livingcomputermuseum/MDE2/README.md

# MDE2 - MASSBUS Disk Emulator

This repository contains the Xilinx VHDL code and PCB designs for the MASSBUS Disk Emulator.

This is used in tandem with the MBS server code to emulate MASSBUS peripherals.
