livingcomputermuseum/MDE2/MDE-DR/MDE-DR-4.parts.txt

Partlist

Exported from MDE-DR-4.brd at 11/24/2014 12:50:32 PM

EAGLE Version 6.4.0 Copyright (c) 1988-2013 CadSoft

Assembly variant: 

Part     Value           Package       Library         Position (inch)       Orientation

C1       47u             C/6032-28R    rcl             (0.48 4.7)            R90
C2       47u             C/6032-28R    rcl             (8.96 4.7)            R90
C3       47u             C/6032-28R    rcl             (0.48 3.9)            R90
C4       47u             C/6032-28R    rcl             (8.96 3.9)            R90
C5       47u             C/6032-28R    rcl             (0.48 3.1)            R90
C6       47u             C/6032-28R    rcl             (8.96 3.1)            R90
C100     0.01u           C0805K        rcl             (7.6 3.25)            MR0
C101     0.01u           C0805K        rcl             (6.8 3.25)            MR0
C102     0.01u           C0805K        rcl             (5.2 3.25)            MR0
C103     0.01u           C0805K        rcl             (4.4 3.25)            MR0
C104     0.01u           C0805K        rcl             (3.6 3.25)            MR0
C105     0.01u           C0805K        rcl             (2.8 3.25)            MR0
C106     0.01u           C0805K        rcl             (2 3.25)              MR0
C107     0.01u           C0805K        rcl             (1.2 3.25)            MR0
C108     0.01u           C0805K        rcl             (8.4 3.285)           MR0
C109     0.01u           C0805K        rcl             (6 3.39)              MR0
C110     0.01u           C0805K        rcl             (8.4 4.05)            MR0
C111     0.01u           C0805K        rcl             (7.6 4.05)            MR0
C112     0.01u           C0805K        rcl             (6.8 4.05)            MR0
C113     0.01u           C0805K        rcl             (6 4.05)              MR0
C114     0.01u           C0805K        rcl             (5.2 4.05)            MR0
C115     0.01u           C0805K        rcl             (4.4 4.05)            MR0
C116     0.01u           C0805K        rcl             (3.6 4.05)            MR0
C117     0.01u           C0805K        rcl             (2.8 4.05)            MR0
C118     0.01u           C0805K        rcl             (2 4.05)              MR0
C119     0.01u           C0805K        rcl             (1.2 4.05)            MR0
C120     0.01u           C0805K        rcl             (8.38 4.85)           MR0
C121     0.01u           C0805K        rcl             (7.56 4.85)           MR0
C122     0.01u           C0805K        rcl             (6.8 4.85)            MR0
C123     0.01u           C0805K        rcl             (6 4.85)              MR0
C124     0.01u           C0805K        rcl             (5.2 4.85)            MR0
C125     0.01u           C0805K        rcl             (4.4 4.85)            MR0
C126     0.01u           C0805K        rcl             (3.6 4.85)            MR0
C127     0.01u           C0805K        rcl             (2.8 4.85)            MR0
C128     0.01u           C0805K        rcl             (2 4.85)              MR0
C129     0.01u           C0805K        rcl             (1.2 4.85)            MR0
D100     HSMS-2822       SOT23         diode           (8.63 1.8)            MR180
D101     HSMS-2822       SOT23         diode           (5.94 1.8)            MR180
D102     HSMS-2822       SOT23         diode           (3.25 1.8)            MR180
D103     1SMB5918BT3G    SMB           diode           (8.75 2.12)           MR180
J1       712RA           712RA         vulcan_custom   (9.05 2.5)            R180
LED1     APT2012SGC      SML0805       led             (8.78 2.56)           R180
LED2     APT2012EC       SML0805       led             (6.32 1.81)           R90
LED3     APT2012EC       SML0805       led             (0.94 1.8)            R90
LED4     APT2012EC       SML0805       led             (3.63 1.8)            R90
P1                       CON50L        vulcan_custom   (1.7 5.6)             R180
P2                       CON50L        vulcan_custom   (4.8 5.6)             R180
P3                       CON50L        vulcan_custom   (7.9 5.6)             R180
P4                       CON40L        vulcan_custom   (2.15 1.8)            R180
P5                       CON40L        vulcan_custom   (4.85 1.8)            R180
P6                       CON40L        vulcan_custom   (7.55 1.8)            R180
P7                       CON40L        vulcan_custom   (2.15 1.3)            R180
P8                       CON40L        vulcan_custom   (4.85 1.3)            R180
P9                       CON40L        vulcan_custom   (7.55 1.3)            R180
P10                      CON40L        vulcan_custom   (2.15 0.8)            R180
P11                      CON40L        vulcan_custom   (4.85 0.8)            R180
P12                      CON40L        vulcan_custom   (7.55 0.8)            R180
Q1       IRF7104PBF      SO-08         vulcan_custom   (6 3.16)              R270
Q2       IRF7104PBF      SO-08         vulcan_custom   (6 2.86)              R270
R1       150             R0805         rcl             (8.77 2.36)           R0
R2       150             R0805         rcl             (6.32 2)              R90
R3       150             R0805         rcl             (0.94 1.99)           R90
R4       150             R0805         rcl             (3.63 1.99)           R90
R100     4816P-T02-820LF 4816P         resistor-bourns (8.2 0.3)             MR180
R101     4816P-T02-820LF 4816P         resistor-bourns (7.2 0.3)             MR180
R102     4816P-T02-820LF 4816P         resistor-bourns (6.2 0.3)             MR180
R103     4816P-T02-820LF 4816P         resistor-bourns (5.3 0.3)             MR180
R104     4816P-T02-820LF 4816P         resistor-bourns (4.3 0.3)             MR180
R105     4816P-T02-820LF 4816P         resistor-bourns (3.4 0.3)             MR180
R106     4816P-T02-820LF 4816P         resistor-bourns (2.3 0.3)             MR180
R107     4816P-T02-820LF 4816P         resistor-bourns (1.4 0.3)             MR180
R108     10k             R0805         rcl             (5.71 3.01)           MR0
R109     1.0k            R0805         rcl             (2.8 3.1)             MR0
R110     10k             R0805         rcl             (5.71 3.14)           MR0
R111     10k             R0805         rcl             (5.71 3.24)           MR0
R112     1.0k            R0805         rcl             (3.6 3.37)            MR0
R113     1.0k            R0805         rcl             (2.8 3.37)            MR0
R114     1.0k            R0805         rcl             (8.4 3.405)           MR0
R115     1.0k            R0805         rcl             (6 3.82)              MR0
R116     1.0k            R0805         rcl             (8.4 4.17)            MR0
R117     1.0k            R0805         rcl             (3.6 4.17)            MR0
R118     1.0k            R0805         rcl             (2.81 4.18)           MR0
R119     1.0k            R0805         rcl             (3.6 4.42)            MR0
R120     1.0k            R0805         rcl             (6 4.43)              MR0
R121     1.0k            R0805         rcl             (2.81 4.43)           MR0
R122     1.0k            R0805         rcl             (2.8 4.66)            MR0
R123     1.0k            R0805         rcl             (6 4.69)              MR0
TP100    TPSTP12R        TP12R         testpad         (6.49 0.17)           MR0
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
TP188    TPSTP12R        TP12R         testpad         (2.78 5.295)          MR270
TP189    TPSTP12R        TP12R         testpad         (2.64 5.295)          MR270
TP190    TPSTP12R        TP12R         testpad         (2.5 5.295)           MR270
U1       SN751177NSR"    SO16NS        vulcan_custom   (1.2 4.7)             R270
U2       SN751177NSR"    SO16NS        vulcan_custom   (2 4.7)               R270
U3       SN751177NSR"    SO16NS        vulcan_custom   (2.8 4.7)             R270
U4       SN751177NSR"    SO16NS        vulcan_custom   (3.6 4.7)             R270
U5       SN751177NSR"    SO16NS        vulcan_custom   (4.4 4.7)             R270
U6       SN751177NSR"    SO16NS        vulcan_custom   (5.2 4.7)             R270
U7       SN751177NSR"    SO16NS        vulcan_custom   (6 4.7)               R270
U8       SN751177NSR"    SO16NS        vulcan_custom   (6.8 4.7)             R270
U9       SN751177NSR"    SO16NS        vulcan_custom   (7.56 4.7)            R270
U10      SN751177NSR"    SO16NS        vulcan_custom   (8.38 4.7)            R270
U11      SN751177NSR"    SO16NS        vulcan_custom   (1.2 3.9)             R270
U12      SN751177NSR"    SO16NS        vulcan_custom   (2 3.9)               R270
U13      SN751177NSR"    SO16NS        vulcan_custom   (2.8 3.9)             R270
U14      SN751177NSR"    SO16NS        vulcan_custom   (3.6 3.9)             R270
U15      SN751177NSR"    SO16NS        vulcan_custom   (4.4 3.9)             R270
U16      SN751177NSR"    SO16NS        vulcan_custom   (5.2 3.9)             R270
U17      SN751177NSR"    SO16NS        vulcan_custom   (6 3.9)               R270
U18      SN751177NSR"    SO16NS        vulcan_custom   (6.8 3.9)             R270
U19      SN751177NSR"    SO16NS        vulcan_custom   (7.6 3.9)             R270
U20      SN751177NSR"    SO16NS        vulcan_custom   (8.4 3.9)             R270
U21      SN74LVC1G27DBV  DBV_R-PDSO-G6 vulcan_custom   (6 3.39)              R270
U22      SN751177NSR"    SO16NS        vulcan_custom   (1.2 3.1)             R270
U23      SN751177NSR"    SO16NS        vulcan_custom   (2 3.1)               R270
U24      SN751177NSR"    SO16NS        vulcan_custom   (2.8 3.1)             R270
U25      SN751177NSR"    SO16NS        vulcan_custom   (3.6 3.1)             R270
U26      SN751177NSR"    SO16NS        vulcan_custom   (4.4 3.1)             R270
U27      SN751177NSR"    SO16NS        vulcan_custom   (5.2 3.1)             R270
U28      SN751177NSR"    SO16NS        vulcan_custom   (6.8 3.1)             R270
U29      SN751177NSR"    SO16NS        vulcan_custom   (7.6 3.1)             R270
U30      SN751177NSR"    SO16NS        vulcan_custom   (8.4 3.1)             R270
