livingcomputermuseum/MDE2/MDE-DR/MDE-DR-4.xy.xls

Part | Value | Package | Library | Position | inch | Orientation
Top Surface Components
C1 | 47u | C/6032-28R | 0.48 | 4.7 | R90
C2 | 47u | C/6032-28R | 8.96 | 4.7 | R90
C3 | 47u | C/6032-28R | 0.48 | 3.9 | R90
C4 | 47u | C/6032-28R | 8.96 | 3.9 | R90
C5 | 47u | C/6032-28R | 0.48 | 3.1 | R90
C6 | 47u | C/6032-28R | 8.96 | 3.1 | R90
LED1 | APT2012SGC | SML0805 | 8.78 | 2.56 | R180
LED2 | APT2012EC | SML0805 | 6.32 | 1.81 | R90
LED3 | APT2012EC | SML0805 | 0.94 | 1.8 | R90
LED4 | APT2012EC | SML0805 | 3.63 | 1.8 | R90
Q1 | IRF7104PBF | SO-08 | 6 | 3.16 | R270
Q2 | IRF7104PBF | SO-08 | 6 | 2.86 | R270
R1 | 150 | R0805 | 8.77 | 2.36 | R0
R2 | 150 | R0805 | 6.32 | 2 | R90
R3 | 150 | R0805 | 0.94 | 1.99 | R90
R4 | 150 | R0805 | 3.63 | 1.99 | R90
U1 | SN751177NSR | SO16NS | 1.2 | 4.7 | R270
U2 | SN751177NSR | SO16NS | 2 | 4.7 | R270
U3 | SN751177NSR | SO16NS | 2.8 | 4.7 | R270
U4 | SN751177NSR | SO16NS | 3.6 | 4.7 | R270
U5 | SN751177NSR | SO16NS | 4.4 | 4.7 | R270
U6 | SN751177NSR | SO16NS | 5.2 | 4.7 | R270
U7 | SN751177NSR | SO16NS | 6 | 4.7 | R270
U8 | SN751177NSR | SO16NS | 6.8 | 4.7 | R270
U9 | SN751177NSR | SO16NS | 7.56 | 4.7 | R270
U10 | SN751177NSR | SO16NS | 8.38 | 4.7 | R270
U11 | SN751177NSR | SO16NS | 1.2 | 3.9 | R270
U12 | SN751177NSR | SO16NS | 2 | 3.9 | R270
U13 | SN751177NSR | SO16NS | 2.8 | 3.9 | R270
U14 | SN751177NSR | SO16NS | 3.6 | 3.9 | R270
U15 | SN751177NSR | SO16NS | 4.4 | 3.9 | R270
U16 | SN751177NSR | SO16NS | 5.2 | 3.9 | R270
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
R120 | 1.0k | R0805 | 6 | 4.43 | MR0
R121 | 1.0k | R0805 | 2.81 | 4.43 | MR0
R122 | 1.0k | R0805 | 2.8 | 4.66 | MR0
R123 | 1.0k | R0805 | 6 | 4.69 | MR0
R108 | 10k | R0805 | 5.71 | 3.01 | MR0
R110 | 10k | R0805 | 5.71 | 3.14 | MR0
R111 | 10k | R0805 | 5.71 | 3.24 | MR0
