livingcomputermuseum/MDE2/MDE-DR/MDE-DR-4.brd.pdf

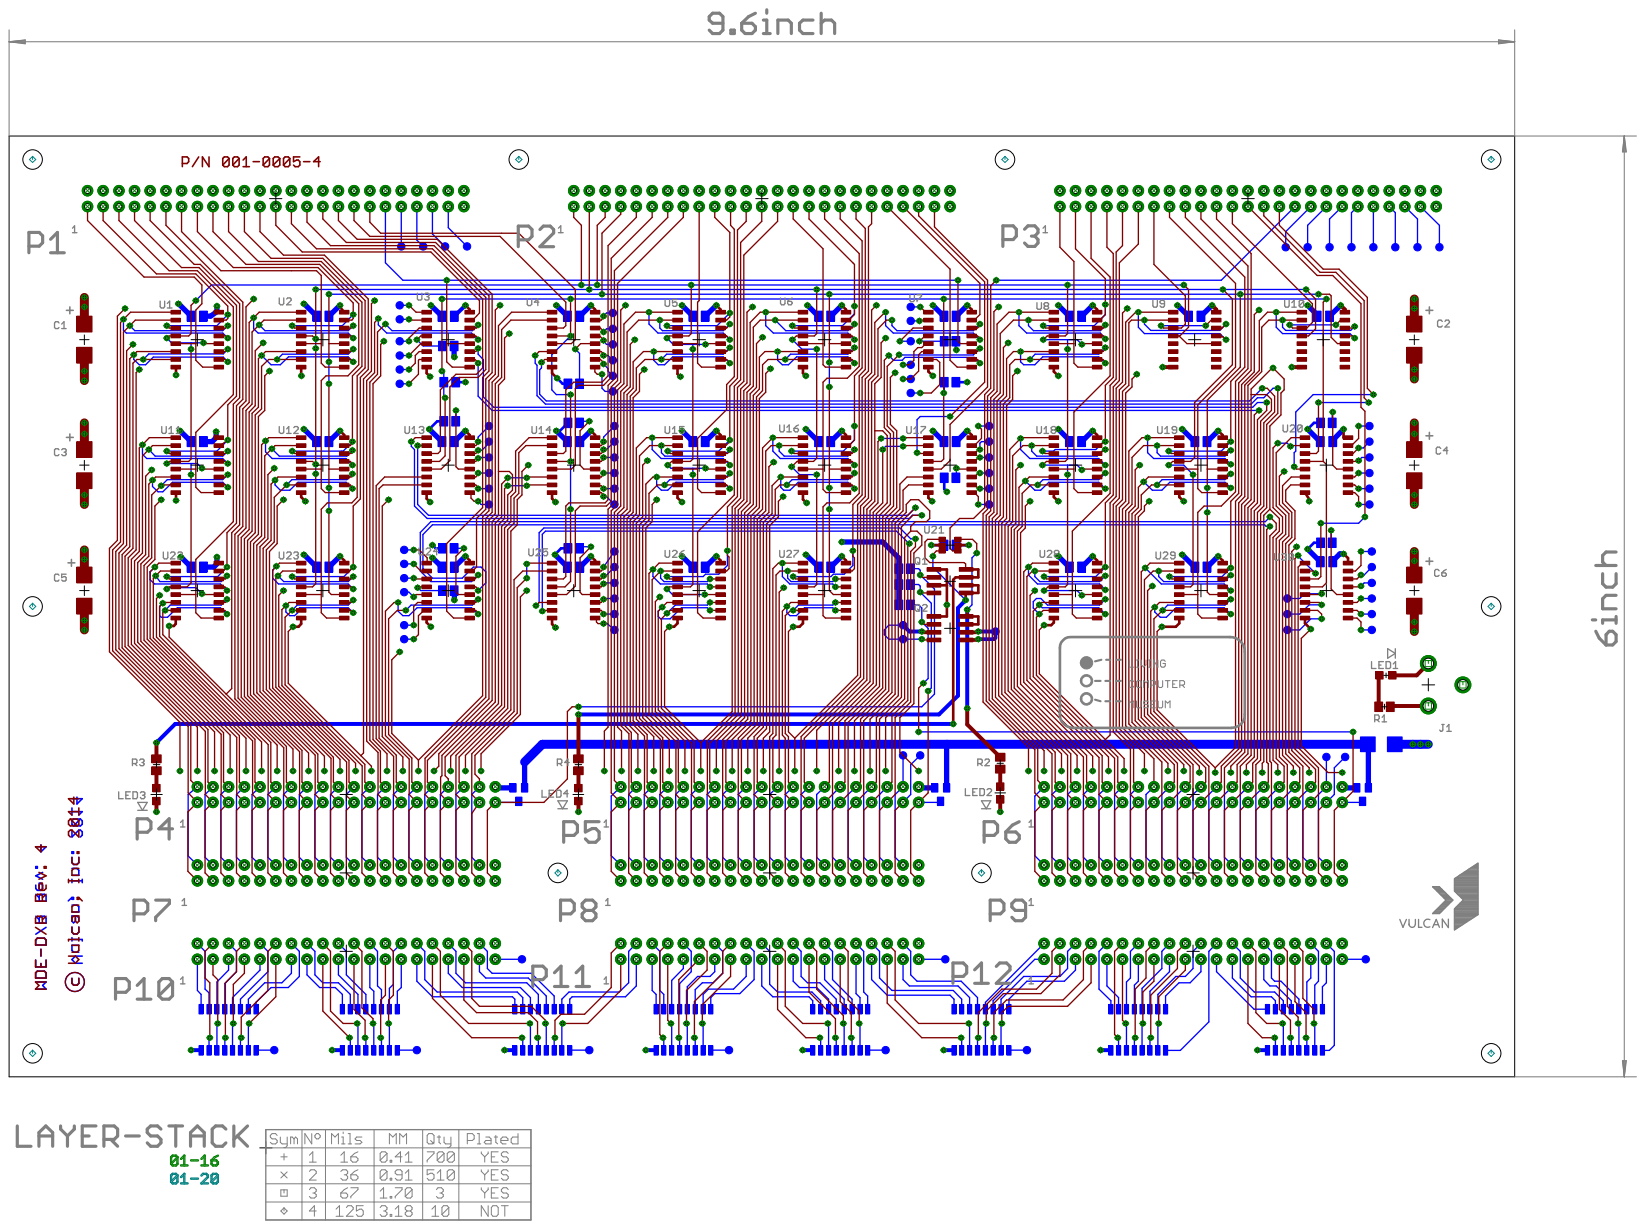
[picture p1: page 1]
