livingcomputermuseum/MDE2/MDE-DR/MDE-DR-4.brd

## EAGLE design MDE-DR/MDE-DR-4.brd (2017-12-08)

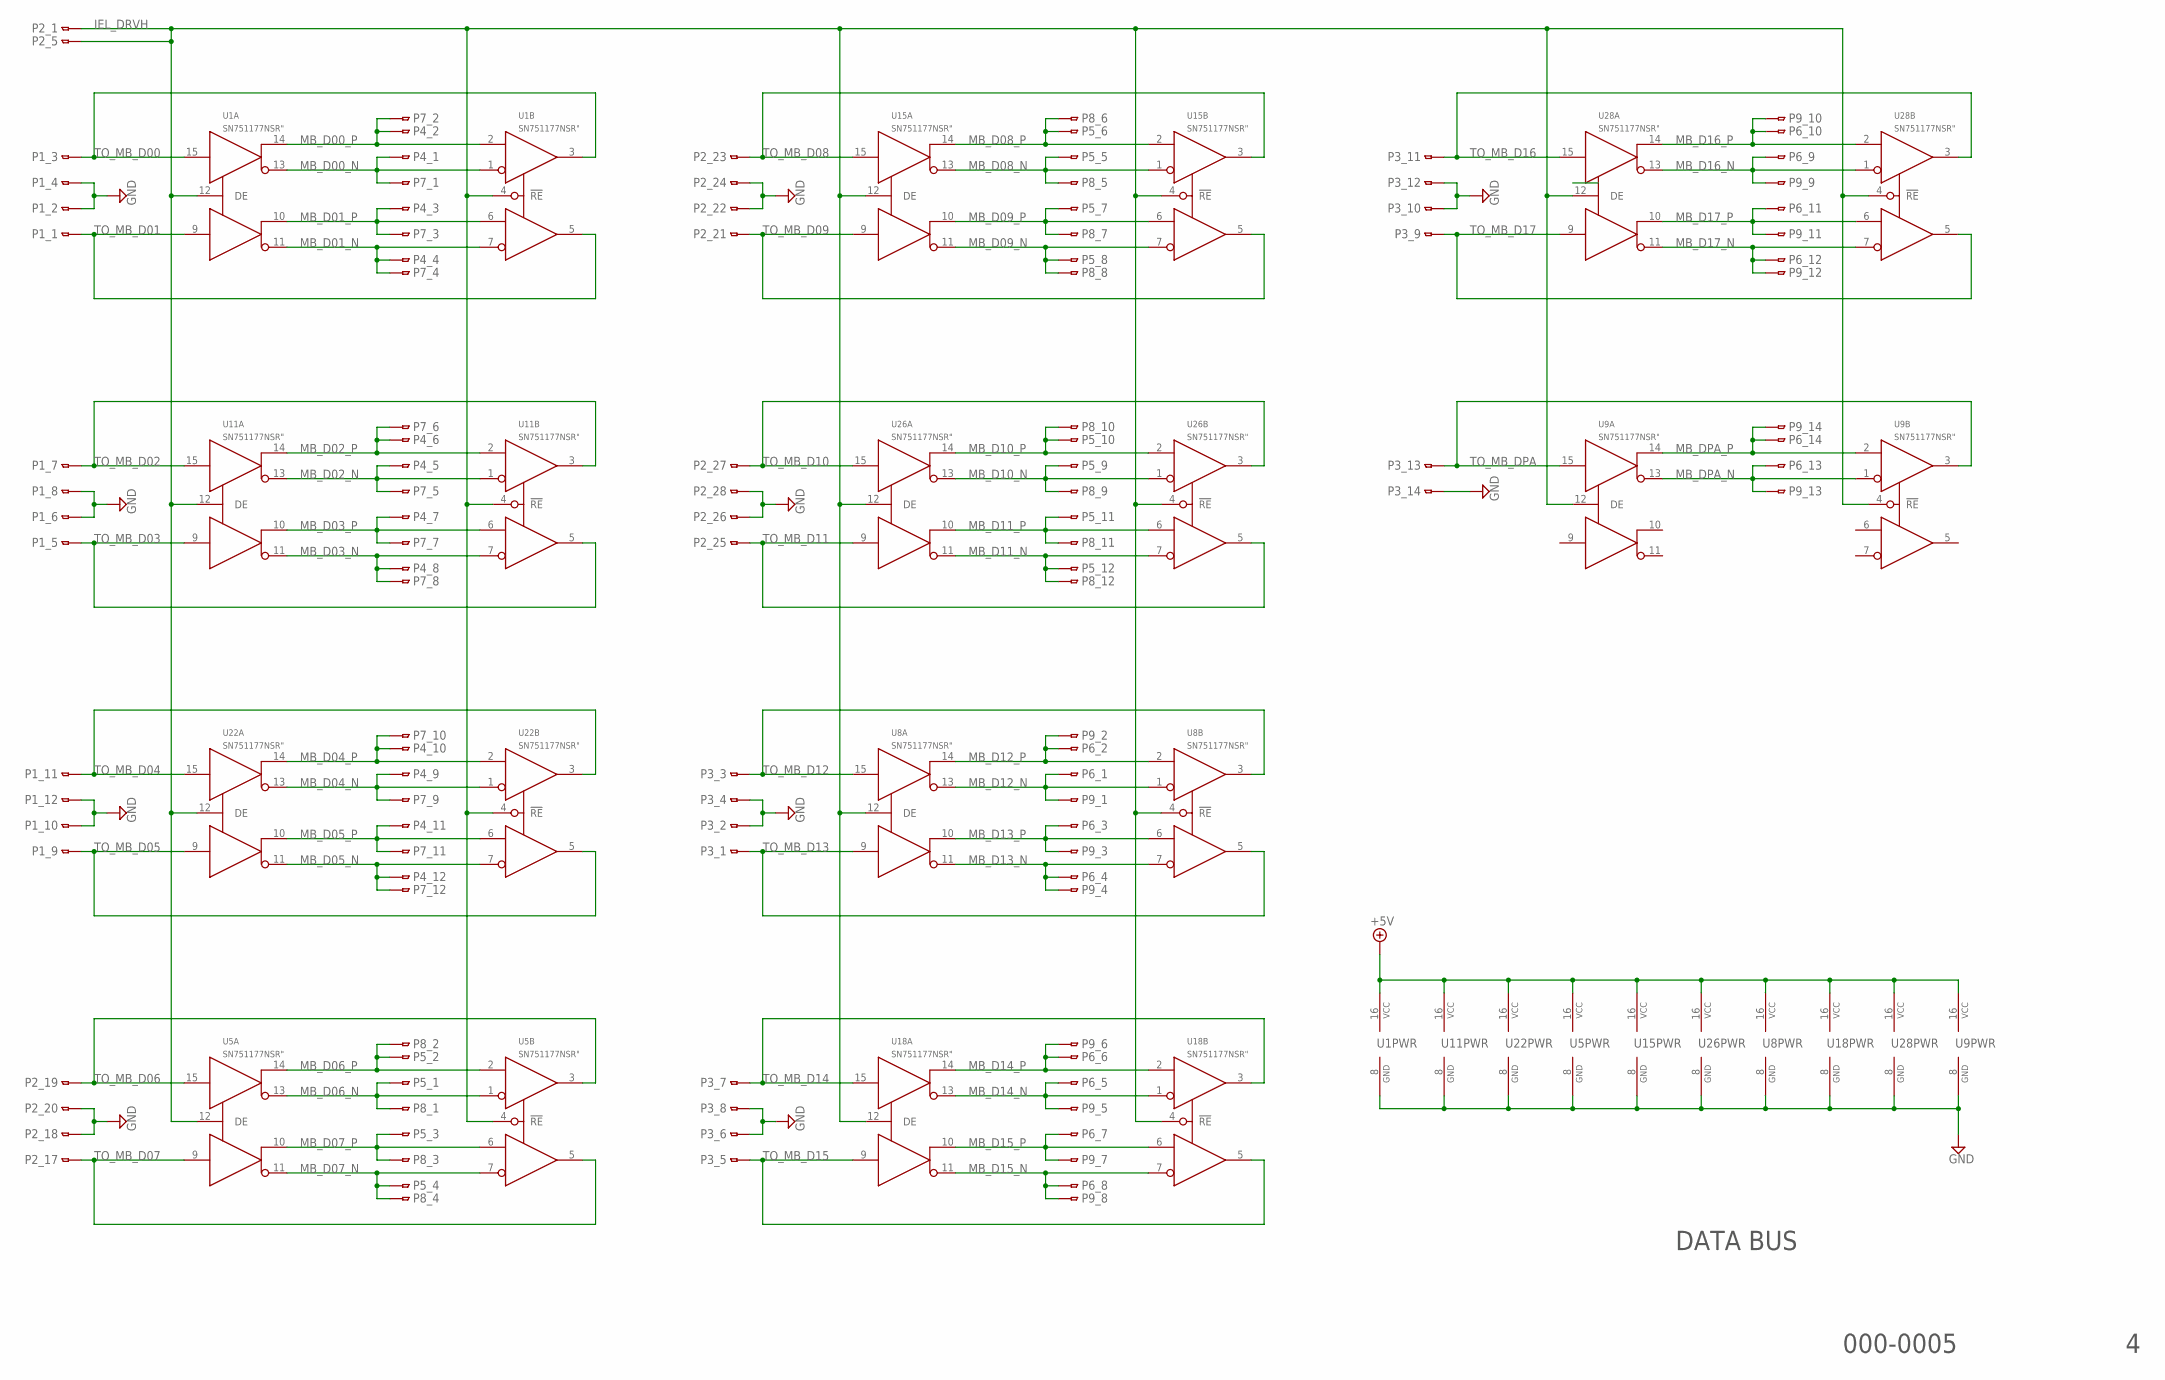
[picture p6: schematic MDE-DR-4.sch, sheet 1]

Parts:
P1, P2, P3: CON50L
P4, P5, P6, P7, P8, P9: CON40L
U1, U5, U8, U9, U11, U15, U18, U22, U26, U28: SN751177NSR"; SO16NS

Connections:
+5V: U1.16 (VCC), U5.16 (VCC), U8.16 (VCC), U9.16 (VCC), U11.16 (VCC), U15.16 (VCC), U18.16 (VCC), U22.16 (VCC), U26.16 (VCC), U28.16 (VCC); also elsewhere on the board
GND: P1.2, P1.4, P1.6, P1.8, P1.10, P1.12, P2.18, P2.20, P2.22, P2.24, P2.26, P2.28, P3.2, P3.4, P3.6, P3.8, P3.10, P3.12, P3.14, U1.8 (GND), U5.8 (GND), U8.8 (GND), U9.8 (GND), U11.8 (GND), U15.8 (GND), U18.8 (GND), U22.8 (GND), U26.8 (GND), U28.8 (GND); also elsewhere on the board
IEL_DRVH: P2.1, P2.5, U1.4 (!RE), U1.12 (DE), U5.4 (!RE), U5.12 (DE), U8.4 (!RE), U8.12 (DE), U9.4 (!RE), U9.12 (DE), U11.4 (!RE), U11.12 (DE), U15.4 (!RE), U15.12 (DE), U18.4 (!RE), U18.12 (DE), U22.4 (!RE), U22.12 (DE), U26.4 (!RE), U26.12 (DE), U28.4 (!RE), U28.12 (DE)
MB_D00_N: P4.1, P7.1, U1.1 (!1B), U1.13 (!1Z)
MB_D00_P: P4.2, P7.2, U1.2 (1A), U1.14 (1Y)
MB_D01_N: P4.4, P7.4, U1.7 (!2B), U1.11 (!2Z)
MB_D01_P: P4.3, P7.3, U1.6 (2A), U1.10 (2Y)
MB_D02_N: P4.5, P7.5, U11.1 (!1B), U11.13 (!1Z)
MB_D02_P: P4.6, P7.6, U11.2 (1A), U11.14 (1Y)
MB_D03_N: P4.8, P7.8, U11.7 (!2B), U11.11 (!2Z)
MB_D03_P: P4.7, P7.7, U11.6 (2A), U11.10 (2Y)
MB_D04_N: P4.9, P7.9, U22.1 (!1B), U22.13 (!1Z)
MB_D04_P: P4.10, P7.10, U22.2 (1A), U22.14 (1Y)
MB_D05_N: P4.12, P7.12, U22.7 (!2B), U22.11 (!2Z)
MB_D05_P: P4.11, P7.11, U22.6 (2A), U22.10 (2Y)
MB_D06_N: P5.1, P8.1, U5.1 (!1B), U5.13 (!1Z)
MB_D06_P: P5.2, P8.2, U5.2 (1A), U5.14 (1Y)
MB_D07_N: P5.4, P8.4, U5.7 (!2B), U5.11 (!2Z)
MB_D07_P: P5.3, P8.3, U5.6 (2A), U5.10 (2Y)
MB_D08_N: P5.5, P8.5, U15.1 (!1B), U15.13 (!1Z)
MB_D08_P: P5.6, P8.6, U15.2 (1A), U15.14 (1Y)
MB_D09_N: P5.8, P8.8, U15.7 (!2B), U15.11 (!2Z)
MB_D09_P: P5.7, P8.7, U15.6 (2A), U15.10 (2Y)
MB_D10_N: P5.9, P8.9, U26.1 (!1B), U26.13 (!1Z)
MB_D10_P: P5.10, P8.10, U26.2 (1A), U26.14 (1Y)
MB_D11_N: P5.12, P8.12, U26.7 (!2B), U26.11 (!2Z)
MB_D11_P: P5.11, P8.11, U26.6 (2A), U26.10 (2Y)
MB_D12_N: P6.1, P9.1, U8.1 (!1B), U8.13 (!1Z)
MB_D12_P: P6.2, P9.2, U8.2 (1A), U8.14 (1Y)
MB_D13_N: P6.4, P9.4, U8.7 (!2B), U8.11 (!2Z)
MB_D13_P: P6.3, P9.3, U8.6 (2A), U8.10 (2Y)
MB_D14_N: P6.5, P9.5, U18.1 (!1B), U18.13 (!1Z)
MB_D14_P: P6.6, P9.6, U18.2 (1A), U18.14 (1Y)
MB_D15_N: P6.8, P9.8, U18.7 (!2B), U18.11 (!2Z)
MB_D15_P: P6.7, P9.7, U18.6 (2A), U18.10 (2Y)
MB_D16_N: P6.9, P9.9, U28.1 (!1B), U28.13 (!1Z)
MB_D16_P: P6.10, P9.10, U28.2 (1A), U28.14 (1Y)
MB_D17_N: P6.12, P9.12, U28.7 (!2B), U28.11 (!2Z)
MB_D17_P: P6.11, P9.11, U28.6 (2A), U28.10 (2Y)
MB_DPA_N: P6.13, P9.13, U9.1 (!1B), U9.13 (!1Z)
MB_DPA_P: P6.14, P9.14, U9.2 (1A), U9.14 (1Y)
TO_MB_D00: P1.3, U1.3 (1R), U1.15 (1D)
TO_MB_D01: P1.1, U1.5 (2R), U1.9 (2D)
TO_MB_D02: P1.7, U11.3 (1R), U11.15 (1D)
TO_MB_D03: P1.5, U11.5 (2R), U11.9 (2D)
TO_MB_D04: P1.11, U22.3 (1R), U22.15 (1D)
TO_MB_D05: P1.9, U22.5 (2R), U22.9 (2D)
TO_MB_D06: P2.19, U5.3 (1R), U5.15 (1D)
TO_MB_D07: P2.17, U5.5 (2R), U5.9 (2D)
TO_MB_D08: P2.23, U15.3 (1R), U15.15 (1D)
TO_MB_D09: P2.21, U15.5 (2R), U15.9 (2D)
TO_MB_D10: P2.27, U26.3 (1R), U26.15 (1D)
TO_MB_D11: P2.25, U26.5 (2R), U26.9 (2D)
TO_MB_D12: P3.3, U8.3 (1R), U8.15 (1D)
TO_MB_D13: P3.1, U8.5 (2R), U8.9 (2D)
TO_MB_D14: P3.7, U18.3 (1R), U18.15 (1D)
TO_MB_D15: P3.5, U18.5 (2R), U18.9 (2D)
TO_MB_D16: P3.11, U28.3 (1R), U28.15 (1D)
TO_MB_D17: P3.9, U28.5 (2R), U28.9 (2D)
TO_MB_DPA: P3.13, U9.3 (1R), U9.15 (1D)

Notes on the sheet:
DATA BUS
000-0005

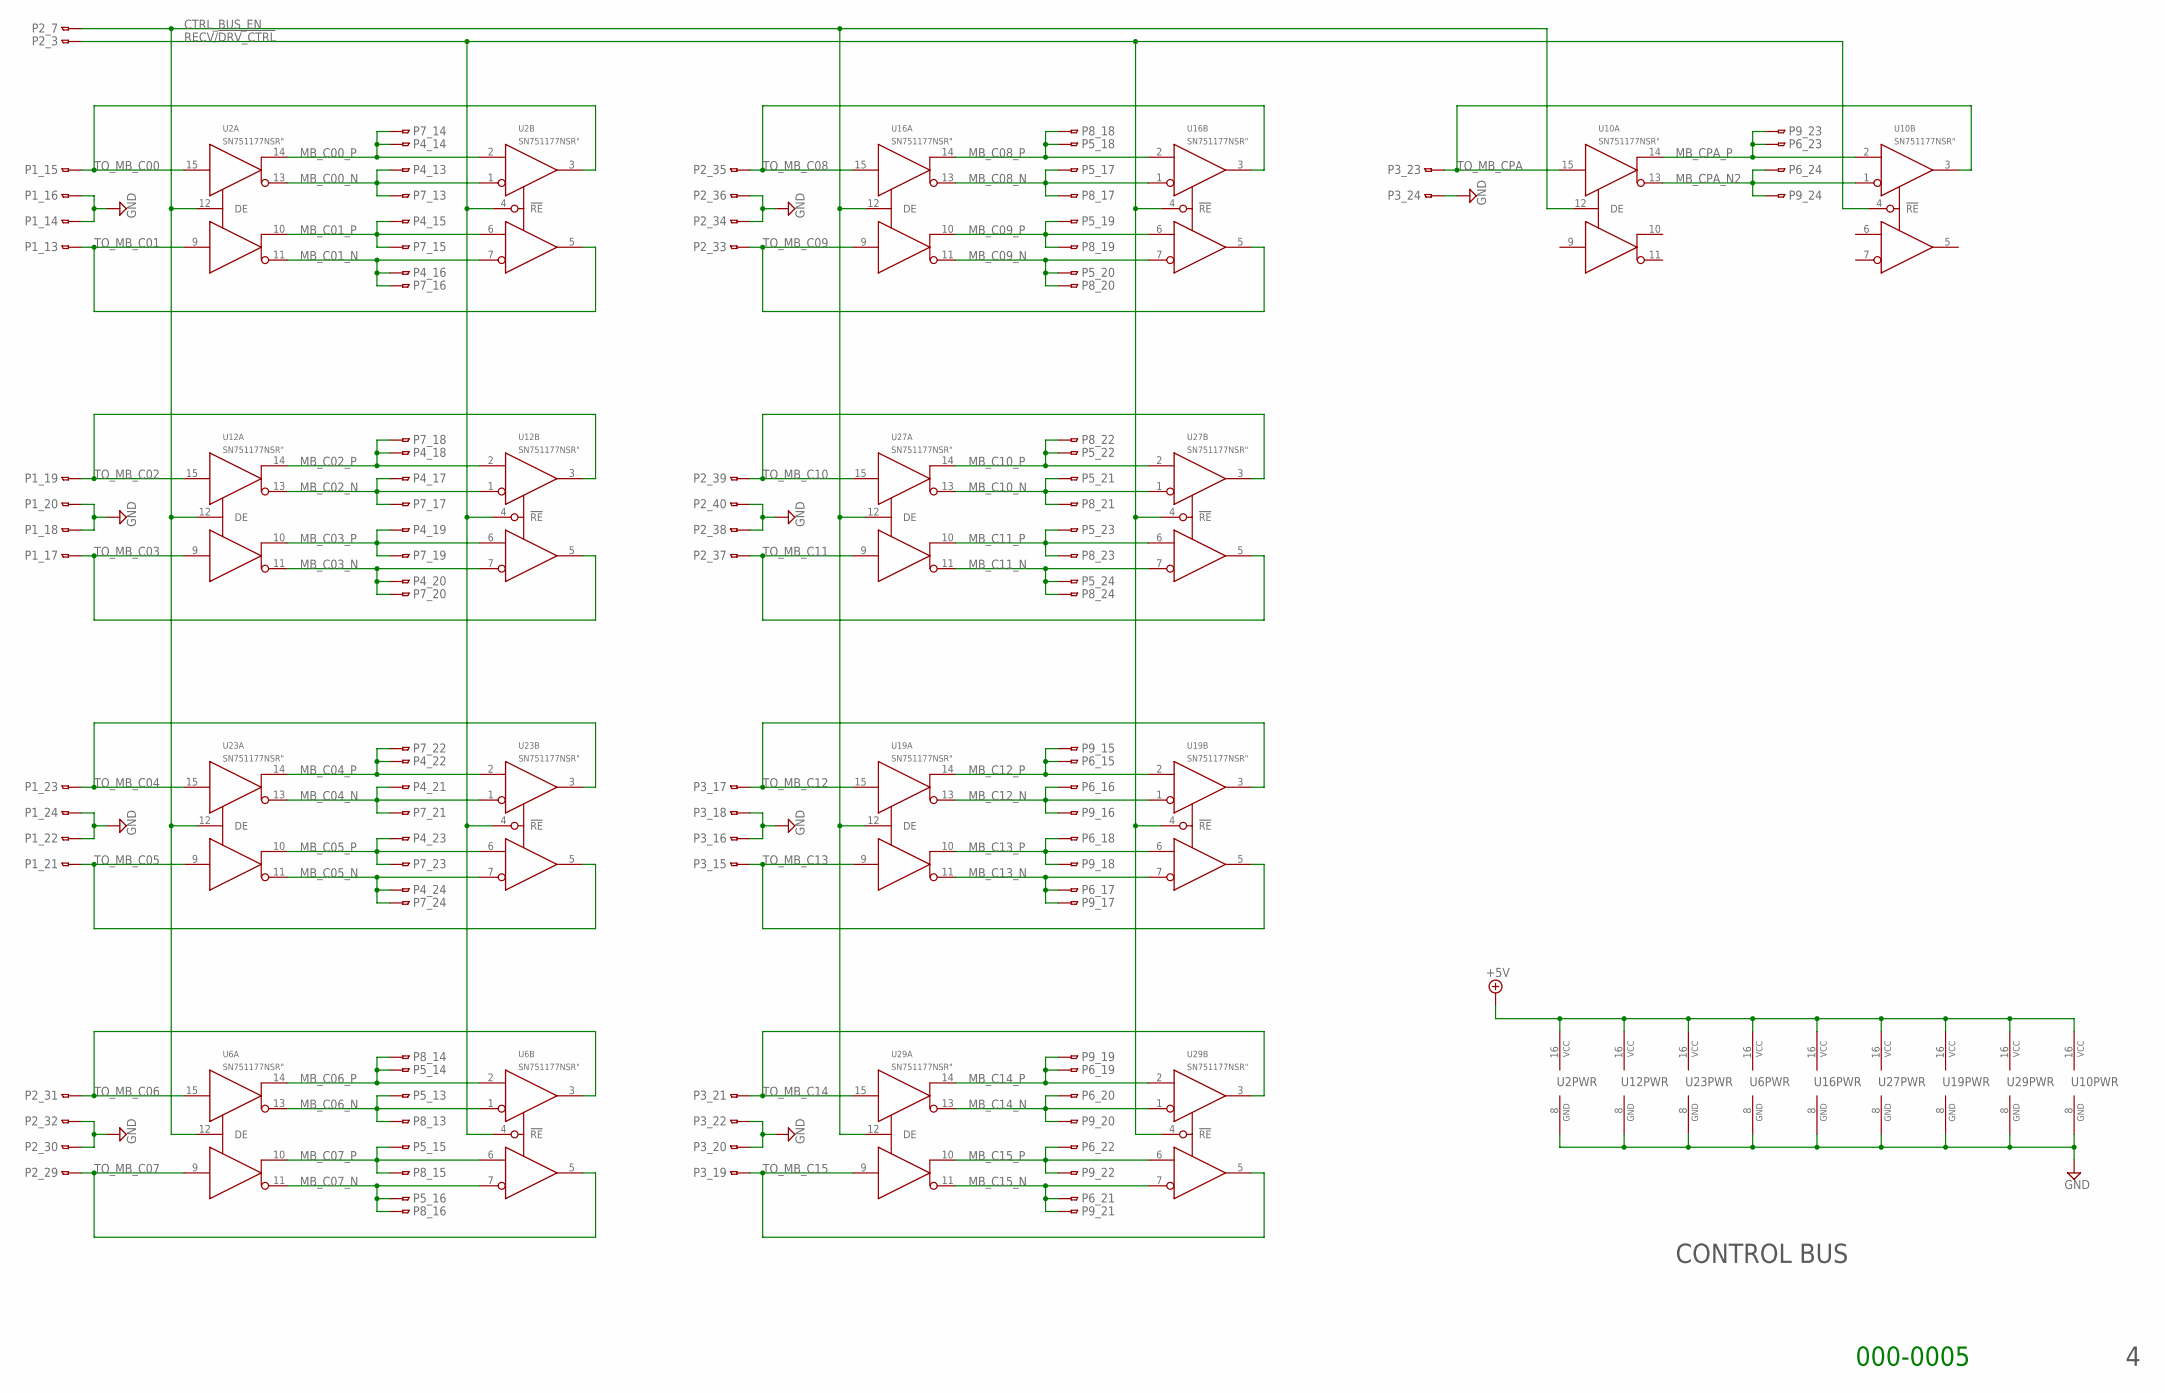
[picture p7: schematic MDE-DR-4.sch, sheet 2]

Parts:
P1, P2, P3: CON50L
P4, P5, P6, P7, P8, P9: CON40L
U2, U6, U10, U12, U16, U19, U23, U27, U29: SN751177NSR"; SO16NS

Connections:
+5V: U2.16 (VCC), U6.16 (VCC), U10.16 (VCC), U12.16 (VCC), U16.16 (VCC), U19.16 (VCC), U23.16 (VCC), U27.16 (VCC), U29.16 (VCC); also elsewhere on the board
CTRL_BUS_EN: P2.7, U2.12 (DE), U6.12 (DE), U10.12 (DE), U12.12 (DE), U16.12 (DE), U19.12 (DE), U23.12 (DE), U27.12 (DE), U29.12 (DE)
GND: P1.14, P1.16, P1.18, P1.20, P1.22, P1.24, P2.30, P2.32, P2.34, P2.36, P2.38, P2.40, P3.16, P3.18, P3.20, P3.22, P3.24, U2.8 (GND), U6.8 (GND), U10.8 (GND), U12.8 (GND), U16.8 (GND), U19.8 (GND), U23.8 (GND), U27.8 (GND), U29.8 (GND); also elsewhere on the board
MB_C00_N: P4.13, P7.13, U2.1 (!1B), U2.13 (!1Z)
MB_C00_P: P4.14, P7.14, U2.2 (1A), U2.14 (1Y)
MB_C01_N: P4.16, P7.16, U2.7 (!2B), U2.11 (!2Z)
MB_C01_P: P4.15, P7.15, U2.6 (2A), U2.10 (2Y)
MB_C02_N: P4.17, P7.17, U12.1 (!1B), U12.13 (!1Z)
MB_C02_P: P4.18, P7.18, U12.2 (1A), U12.14 (1Y)
MB_C03_N: P4.20, P7.20, U12.7 (!2B), U12.11 (!2Z)
MB_C03_P: P4.19, P7.19, U12.6 (2A), U12.10 (2Y)
MB_C04_N: P4.21, P7.21, U23.1 (!1B), U23.13 (!1Z)
MB_C04_P: P4.22, P7.22, U23.2 (1A), U23.14 (1Y)
MB_C05_N: P4.24, P7.24, U23.7 (!2B), U23.11 (!2Z)
MB_C05_P: P4.23, P7.23, U23.6 (2A), U23.10 (2Y)
MB_C06_N: P5.13, P8.13, U6.1 (!1B), U6.13 (!1Z)
MB_C06_P: P5.14, P8.14, U6.2 (1A), U6.14 (1Y)
MB_C07_N: P5.16, P8.16, U6.7 (!2B), U6.11 (!2Z)
MB_C07_P: P5.15, P8.15, U6.6 (2A), U6.10 (2Y)
MB_C08_N: P5.17, P8.17, U16.1 (!1B), U16.13 (!1Z)
MB_C08_P: P5.18, P8.18, U16.2 (1A), U16.14 (1Y)
MB_C09_N: P5.20, P8.20, U16.7 (!2B), U16.11 (!2Z)
MB_C09_P: P5.19, P8.19, U16.6 (2A), U16.10 (2Y)
MB_C10_N: P5.21, P8.21, U27.1 (!1B), U27.13 (!1Z)
MB_C10_P: P5.22, P8.22, U27.2 (1A), U27.14 (1Y)
MB_C11_N: P5.24, P8.24, U27.7 (!2B), U27.11 (!2Z)
MB_C11_P: P5.23, P8.23, U27.6 (2A), U27.10 (2Y)
MB_C12_N: P6.16, P9.16, U19.1 (!1B), U19.13 (!1Z)
MB_C12_P: P6.15, P9.15, U19.2 (1A), U19.14 (1Y)
MB_C13_N: P6.17, P9.17, U19.7 (!2B), U19.11 (!2Z)
MB_C13_P: P6.18, P9.18, U19.6 (2A), U19.10 (2Y)
MB_C14_N: P6.20, P9.20, U29.1 (!1B), U29.13 (!1Z)
MB_C14_P: P6.19, P9.19, U29.2 (1A), U29.14 (1Y)
MB_C15_N: P6.21, P9.21, U29.7 (!2B), U29.11 (!2Z)
MB_C15_P: P6.22, P9.22, U29.6 (2A), U29.10 (2Y)
MB_CPA_N2: P6.24, P9.24, U10.1 (!1B), U10.13 (!1Z)
MB_CPA_P: P6.23, P9.23, U10.2 (1A), U10.14 (1Y)
RECV/!DRV_CTRL: P2.3, U2.4 (!RE), U6.4 (!RE), U10.4 (!RE), U12.4 (!RE), U16.4 (!RE), U19.4 (!RE), U23.4 (!RE), U27.4 (!RE), U29.4 (!RE)
TO_MB_C00: P1.15, U2.3 (1R), U2.15 (1D)
TO_MB_C01: P1.13, U2.5 (2R), U2.9 (2D)
TO_MB_C02: P1.19, U12.3 (1R), U12.15 (1D)
TO_MB_C03: P1.17, U12.5 (2R), U12.9 (2D)
TO_MB_C04: P1.23, U23.3 (1R), U23.15 (1D)
TO_MB_C05: P1.21, U23.5 (2R), U23.9 (2D)
TO_MB_C06: P2.31, U6.3 (1R), U6.15 (1D)
TO_MB_C07: P2.29, U6.5 (2R), U6.9 (2D)
TO_MB_C08: P2.35, U16.3 (1R), U16.15 (1D)
TO_MB_C09: P2.33, U16.5 (2R), U16.9 (2D)
TO_MB_C10: P2.39, U27.3 (1R), U27.15 (1D)
TO_MB_C11: P2.37, U27.5 (2R), U27.9 (2D)
TO_MB_C12: P3.17, U19.3 (1R), U19.15 (1D)
TO_MB_C13: P3.15, U19.5 (2R), U19.9 (2D)
TO_MB_C14: P3.21, U29.3 (1R), U29.15 (1D)
TO_MB_C15: P3.19, U29.5 (2R), U29.9 (2D)
TO_MB_CPA: P3.23, U10.3 (1R), U10.15 (1D)

Notes on the sheet:
CONTROL BUS
000-0005

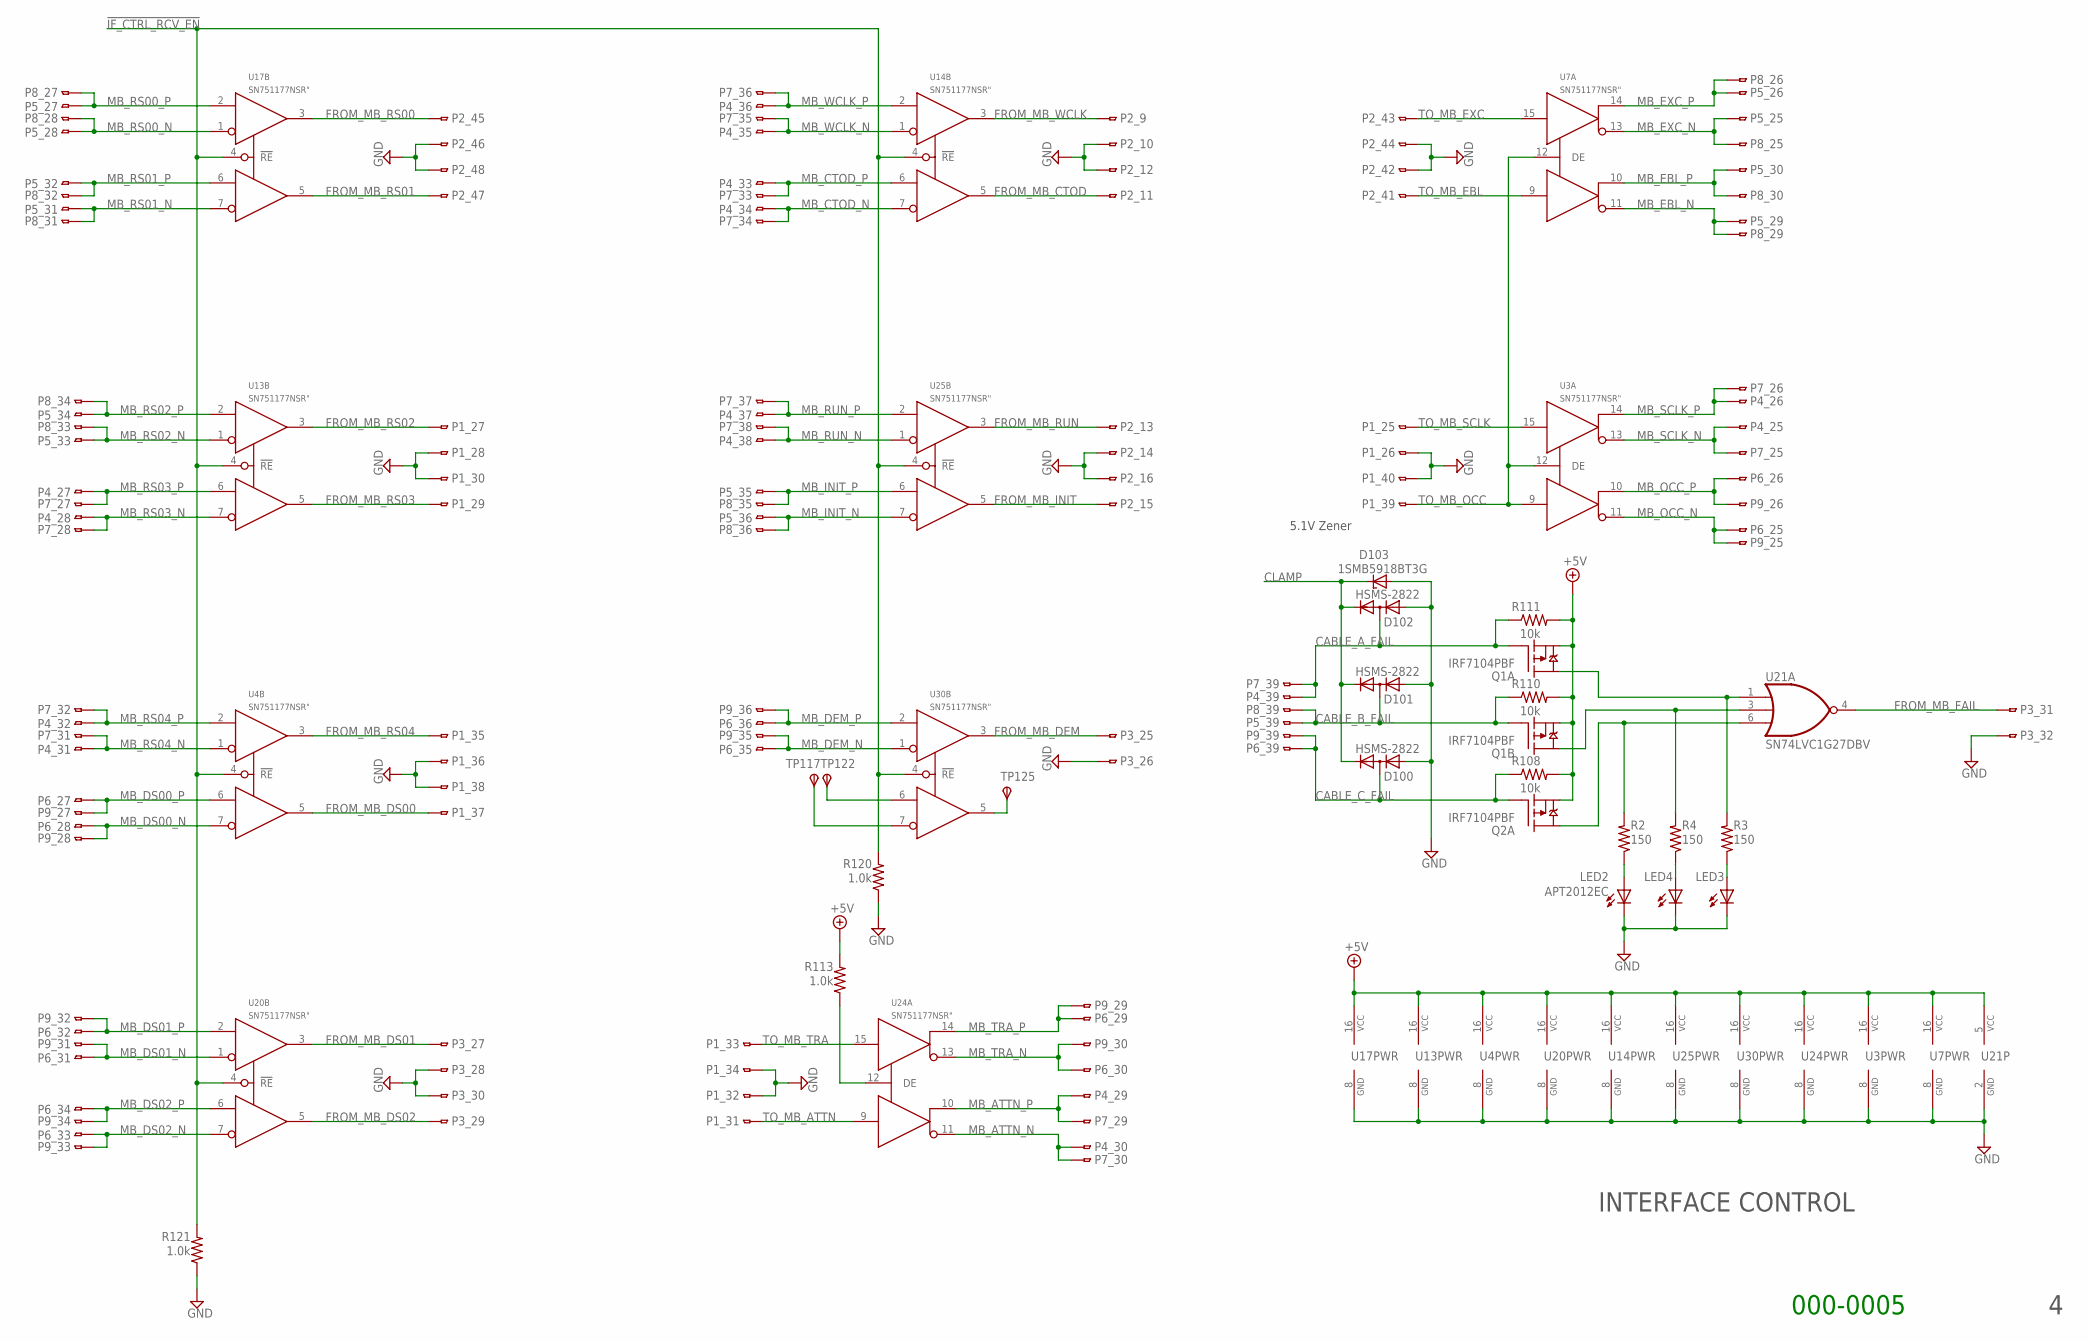
[picture p8: schematic MDE-DR-4.sch, sheet 3]

Parts:
D100, D101, D102: HSMS-2822; SOT23
D103: 1SMB5918BT3G; SMB
LED2, LED3, LED4: APT2012EC; SML0805
P1, P2, P3: CON50L
P4, P5, P6, P7, P8, P9: CON40L
Q1, Q2: IRF7104PBF; SO-08
R2, R3, R4: 150; R0805
R108, R110, R111: 10k; R0805
R113, R120, R121: 1.0k; R0805
TP117, TP122, TP125: TPSTP12R; TP12R
U3, U4, U7, U13, U14, U17, U20, U24, U25, U30: SN751177NSR"; SO16NS
U21: SN74LVC1G27DBV; DBV_R-PDSO-G6

Connections:
!IF_CTRL_RCV_EN: R120.2, R121.2, U4.4 (!RE), U13.4 (!RE), U14.4 (!RE), U17.4 (!RE), U20.4 (!RE), U25.4 (!RE), U30.4 (!RE)
+5V: Q1.1 (S), Q1.3 (S), Q2.1 (S), R108.2, R110.2, R111.2, R113.2, U3.16 (VCC), U4.16 (VCC), U7.16 (VCC), U13.16 (VCC), U14.16 (VCC), U17.16 (VCC), U20.16 (VCC), U21.5 (VCC), U24.16 (VCC), U25.16 (VCC), U30.16 (VCC); also elsewhere on the board
CABLE_A_FAIL: D102.3 (AC), P4.39, P7.39, Q1.2 (G), R111.1
CABLE_B_FAIL: D101.3 (AC), P5.39, P8.39, Q1.4 (G), R110.1
CABLE_C_FAIL: D100.3 (AC), P6.39, P9.39, Q2.2 (G), R108.1
CLAMP: D100.2 (C), D101.2 (C), D102.2 (C), D103.C
FROM_MB_CTOD: P2.11, U14.5 (2R)
FROM_MB_DEM: P3.25, U30.3 (1R)
FROM_MB_DS00: P1.37, U4.5 (2R)
FROM_MB_DS01: P3.27, U20.3 (1R)
FROM_MB_DS02: P3.29, U20.5 (2R)
FROM_MB_FAIL: P3.31, U21.4 (Y)
FROM_MB_INIT: P2.15, U25.5 (2R)
FROM_MB_RS00: P2.45, U17.3 (1R)
FROM_MB_RS01: P2.47, U17.5 (2R)
FROM_MB_RS02: P1.27, U13.3 (1R)
FROM_MB_RS03: P1.29, U13.5 (2R)
FROM_MB_RS04: P1.35, U4.3 (1R)
FROM_MB_RUN: P2.13, U25.3 (1R)
FROM_MB_WCLK: P2.9, U14.3 (1R)
GND: D100.1 (A), D101.1 (A), D102.1 (A), D103.A, LED2.C, LED3.C, LED4.C, P1.26, P1.28, P1.30, P1.32, P1.34, P1.36, P1.38, P1.40, P2.10, P2.12, P2.14, P2.16, P2.42, P2.44, P2.46, P2.48, P3.26, P3.28, P3.30, P3.32, R120.1, R121.1, U3.8 (GND), U4.8 (GND), U7.8 (GND), U13.8 (GND), U14.8 (GND), U17.8 (GND), U20.8 (GND), U21.2 (GND), U24.8 (GND), U25.8 (GND), U30.8 (GND); also elsewhere on the board
MB_ATTN_N: P4.30, P7.30, U24.11 (!2Z)
MB_ATTN_P: P4.29, P7.29, U24.10 (2Y)
MB_CTOD_N: P4.34, P7.34, U14.7 (!2B)
MB_CTOD_P: P4.33, P7.33, U14.6 (2A)
MB_DEM_N: P6.35, P9.35, U30.1 (!1B)
MB_DEM_P: P6.36, P9.36, U30.2 (1A)
MB_DS00_N: P6.28, P9.28, U4.7 (!2B)
MB_DS00_P: P6.27, P9.27, U4.6 (2A)
MB_DS01_N: P6.31, P9.31, U20.1 (!1B)
MB_DS01_P: P6.32, P9.32, U20.2 (1A)
MB_DS02_N: P6.33, P9.33, U20.7 (!2B)
MB_DS02_P: P6.34, P9.34, U20.6 (2A)
MB_EBL_N: P5.29, P8.29, U7.11 (!2Z)
MB_EBL_P: P5.30, P8.30, U7.10 (2Y)
MB_EXC_N: P5.25, P8.25, U7.13 (!1Z)
MB_EXC_P: P5.26, P8.26, U7.14 (1Y)
MB_INIT_N: P5.36, P8.36, U25.7 (!2B)
MB_INIT_P: P5.35, P8.35, U25.6 (2A)
MB_OCC_N: P6.25, P9.25, U3.11 (!2Z)
MB_OCC_P: P6.26, P9.26, U3.10 (2Y)
MB_RS00_N: P5.28, P8.28, U17.1 (!1B)
MB_RS00_P: P5.27, P8.27, U17.2 (1A)
MB_RS01_N: P5.31, P8.31, U17.7 (!2B)
MB_RS01_P: P5.32, P8.32, U17.6 (2A)
MB_RS02_N: P5.33, P8.33, U13.1 (!1B)
MB_RS02_P: P5.34, P8.34, U13.2 (1A)
MB_RS03_N: P4.28, P7.28, U13.7 (!2B)
MB_RS03_P: P4.27, P7.27, U13.6 (2A)
MB_RS04_N: P4.31, P7.31, U4.1 (!1B)
MB_RS04_P: P4.32, P7.32, U4.2 (1A)
MB_RUN_N: P4.38, P7.38, U25.1 (!1B)
MB_RUN_P: P4.37, P7.37, U25.2 (1A)
MB_SCLK_N: P4.25, P7.25, U3.13 (!1Z)
MB_SCLK_P: P4.26, P7.26, U3.14 (1Y)
MB_TRA_N: P6.30, P9.30, U24.13 (!1Z)
MB_TRA_P: P6.29, P9.29, U24.14 (1Y)
MB_WCLK_N: P4.35, P7.35, U14.1 (!1B)
MB_WCLK_P: P4.36, P7.36, U14.2 (1A)
unnamed: R113.1, U24.12 (DE)
unnamed: TP117.TP, U30.7 (!2B)
unnamed: LED2.A, R2.1
unnamed: Q2.7 (D), Q2.8 (D), R2.2, U21.6 (C)
unnamed: Q1.5 (D), Q1.6 (D), R4.2, U21.3 (B)
unnamed: Q1.7 (D), Q1.8 (D), R3.2, U21.1 (A)
unnamed: LED4.A, R4.1
unnamed: LED3.A, R3.1
unnamed: TP125.TP, U30.5 (2R)
unnamed: TP122.TP, U30.6 (2A)
TO_MB_ATTN: P1.31, U24.9 (2D)
TO_MB_EBL: P2.41, U7.9 (2D)
TO_MB_EXC: P2.43, U7.15 (1D)
TO_MB_OCC: P1.39, U3.9 (2D), U3.12 (DE), U7.12 (DE)
TO_MB_SCLK: P1.25, U3.15 (1D)
TO_MB_TRA: P1.33, U24.15 (1D)

Notes on the sheet:
INTERFACE CONTROL
5.1V Zener
000-0005
