livingcomputermuseum/MDE2/MDE-DR/MDE-DR-4.brd

## EAGLE design MDE-DR/MDE-DR-4.brd (continued)

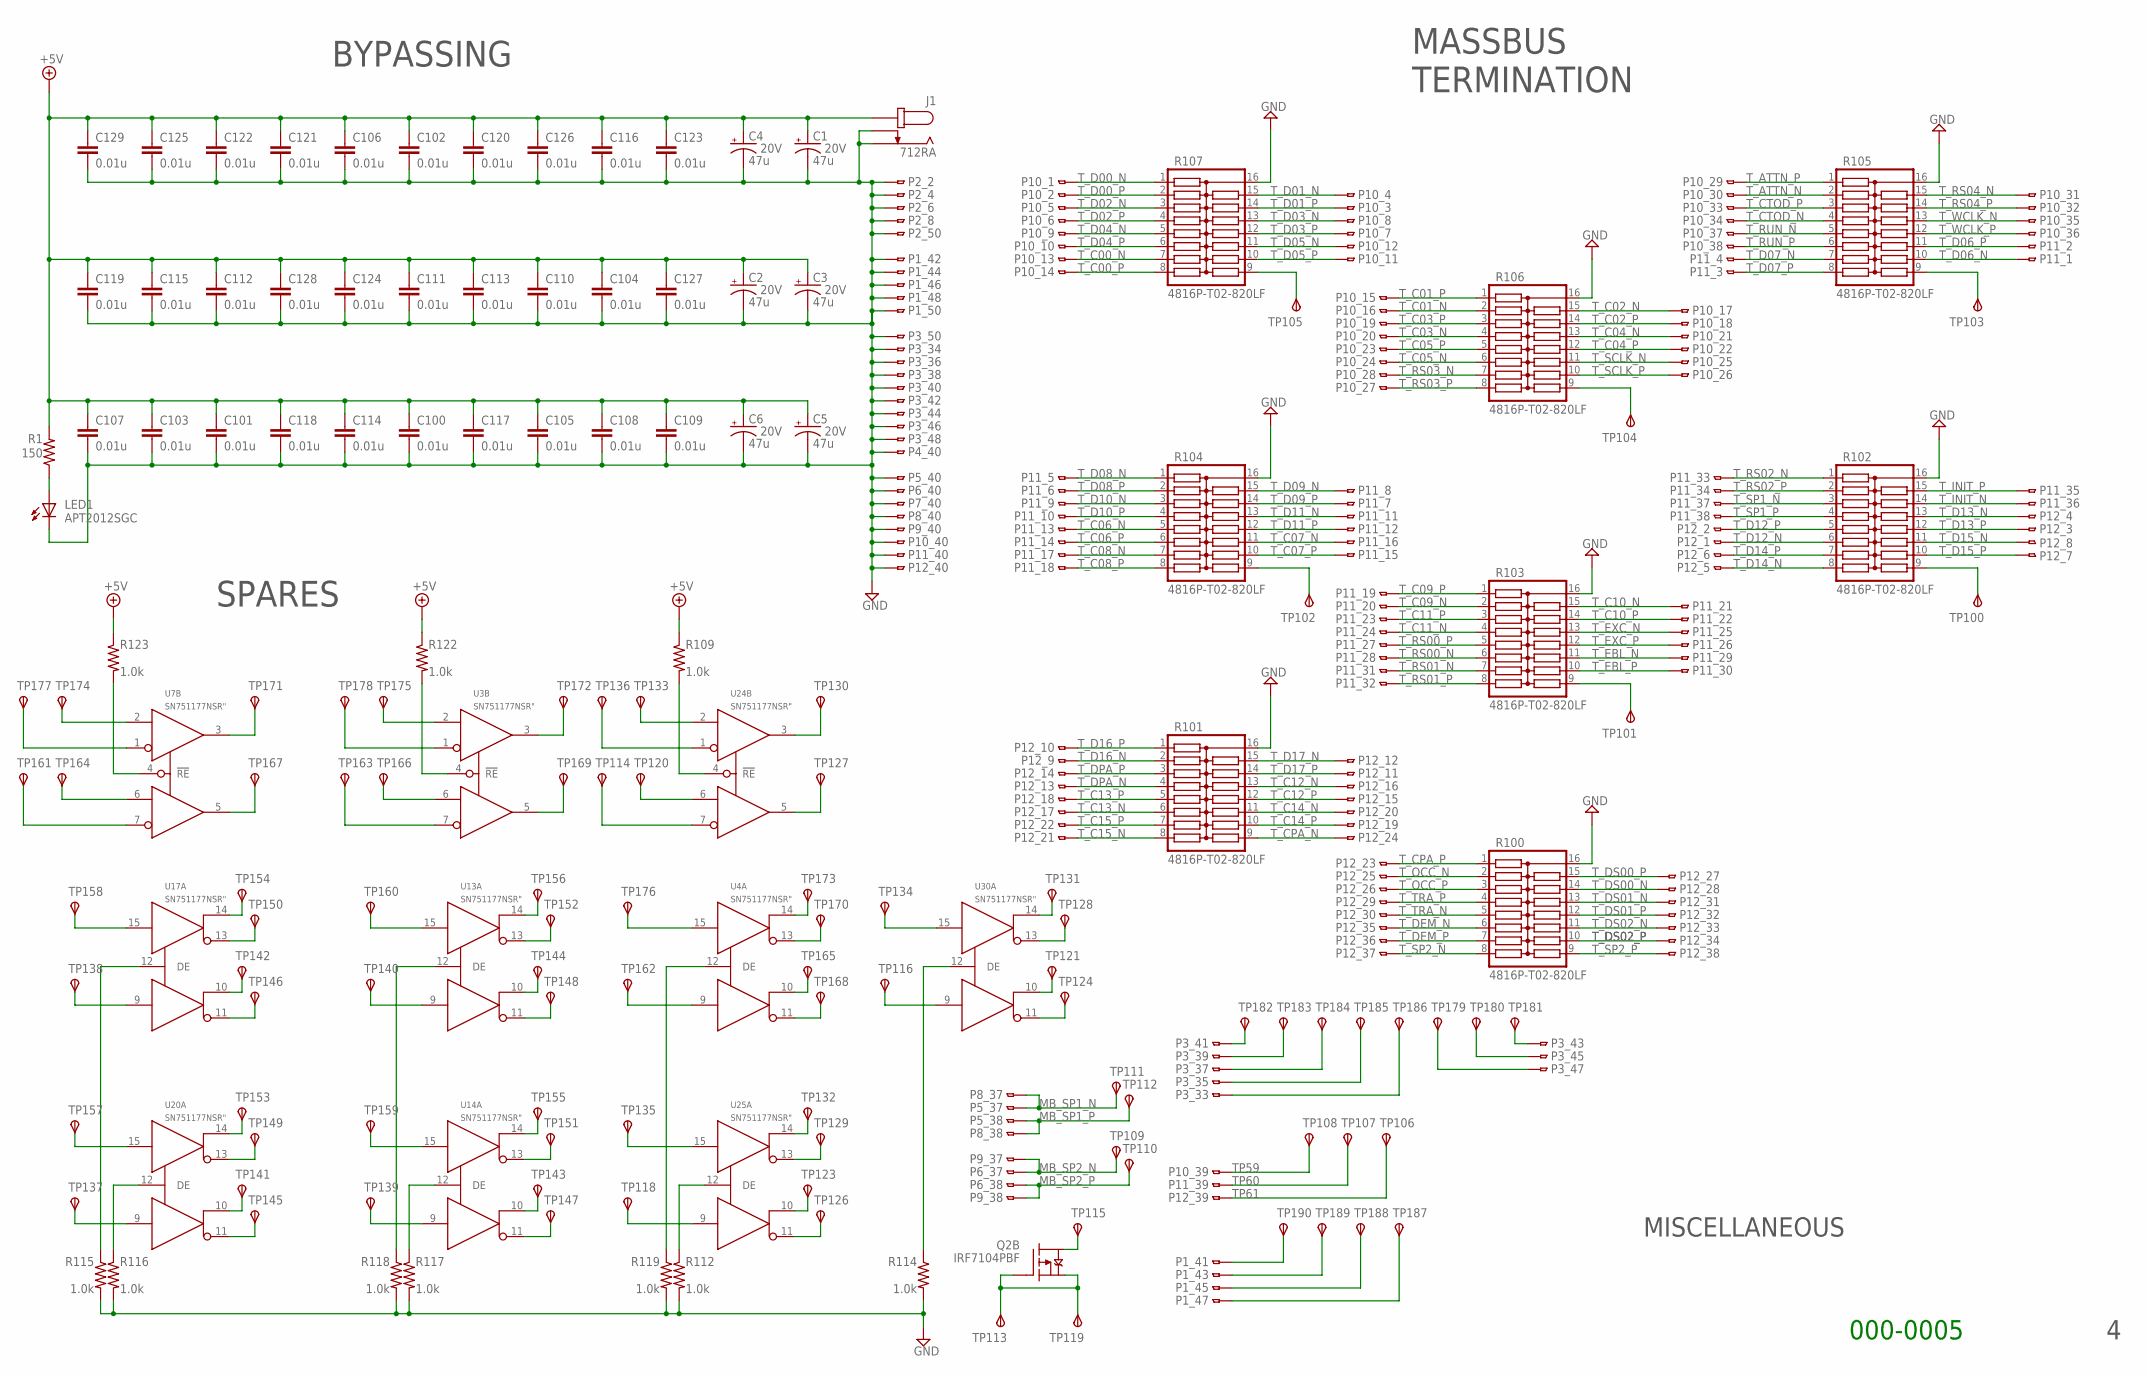
[picture p9: schematic MDE-DR-4.sch, sheet 4]

Parts:
C1, C2, C3, C4, C5, C6: 47u; C/6032-28R; VOLTAGE 20V
C100, C101, C102, C103, C104, C105, C106, C107, C108, C109, C110, C111, C112, C113, C114, C115, C116, C117, C118, C119, C120, C121, C122, C123, C124, C125, C126, C127, C128, C129: 0.01u; C0805K
J1: 712RA
LED1: APT2012SGC; SML0805
P1, P2, P3: CON50L
P4, P5, P6, P7, P8, P9, P10, P11, P12: CON40L
Q2: IRF7104PBF; SO-08
R1: 150; R0805
R100, R101, R102, R103, R104, R105, R106, R107: 4816P-T02-820LF; 4816P
R109, R112, R114, R115, R116, R117, R118, R119, R122, R123: 1.0k; R0805
TP100, TP101, TP102, TP103, TP104, TP105, TP106, TP107, TP108, TP109, TP110, TP111, TP112, TP113, TP114, TP115, TP116, TP118, TP119, TP120, TP121, TP123, TP124, TP126, TP127, TP128, TP129, TP130, TP131, TP132, TP133, TP134, TP135, TP136, TP137, TP138, TP139, TP140, TP141, TP142, TP143, TP144, TP145, TP146, TP147, TP148, TP149, TP150, TP151, TP152, TP153, TP154, TP155, TP156, TP157, TP158, TP159, TP160, TP161, TP162, TP163, TP164, TP165, TP166, TP167, TP168, TP169, TP170, TP171, TP172, TP173, TP174, TP175, TP176, TP177, TP178, TP179, TP180, TP181, TP182, TP183, TP184, TP185, TP186, TP187, TP188, TP189, TP190: TPSTP12R; TP12R
U3, U4, U7, U13, U14, U17, U20, U24, U25, U30: SN751177NSR"; SO16NS

Connections:
+5V: C1.+, C2.+, C3.+, C4.+, C5.+, C6.+, C100.1, C101.1, C102.1, C103.1, C104.1, C105.1, C106.1, C107.1, C108.1, C109.1, C110.1, C111.1, C112.1, C113.1, C114.1, C115.1, C116.1, C117.1, C118.1, C119.1, C120.1, C121.1, C122.1, C123.1, C124.1, C125.1, C126.1, C127.1, C128.1, C129.1, J1.PIN, R1.2, R109.1, R122.1, R123.1; also elsewhere on the board
GND: C1.-, C2.-, C3.-, C4.-, C5.-, C6.-, C100.2, C101.2, C102.2, C103.2, C104.2, C105.2, C106.2, C107.2, C108.2, C109.2, C110.2, C111.2, C112.2, C113.2, C114.2, C115.2, C116.2, C117.2, C118.2, C119.2, C120.2, C121.2, C122.2, C123.2, C124.2, C125.2, C126.2, C127.2, C128.2, C129.2, J1.SLEEVE, J1.SLEEVE_SHUNT, LED1.C, P1.42, P1.44, P1.46, P1.48, P1.50, P2.2, P2.4, P2.6, P2.8, P2.50, P3.34, P3.36, P3.38, P3.40, P3.42, P3.44, P3.46, P3.48, P3.50, P4.40, P5.40, P6.40, P7.40, P8.40, P9.40, P10.40, P11.40, P12.40, R100.16, R101.16, R102.16, R103.16, R104.16, R105.16, R106.16, R107.16, R112.2, R114.2, R115.2, R116.2, R117.2, R118.2, R119.2; also elsewhere on the board
MB_SP1_N: P5.37, P8.37, TP111.TP
MB_SP1_P: P5.38, P8.38, TP112.TP
MB_SP2_N: P6.37, P9.37, TP109.TP
MB_SP2_P: P6.38, P9.38, TP110.TP
unnamed: R119.1, U4.12 (DE)
unnamed: R112.1, U25.12 (DE)
unnamed: TP173.TP, U4.14 (1Y)
unnamed: TP138.TP, U17.9 (2D)
unnamed: TP158.TP, U17.15 (1D)
unnamed: TP157.TP, U20.15 (1D)
unnamed: TP137.TP, U20.9 (2D)
unnamed: TP160.TP, U13.15 (1D)
unnamed: TP140.TP, U13.9 (2D)
unnamed: TP176.TP, U4.15 (1D)
unnamed: TP162.TP, U4.9 (2D)
unnamed: TP135.TP, U25.15 (1D)
unnamed: TP118.TP, U25.9 (2D)
unnamed: TP139.TP, U14.9 (2D)
unnamed: TP159.TP, U14.15 (1D)
unnamed: TP154.TP, U17.14 (1Y)
unnamed: TP150.TP, U17.13 (!1Z)
unnamed: TP142.TP, U17.10 (2Y)
unnamed: TP146.TP, U17.11 (!2Z)
unnamed: TP156.TP, U13.14 (1Y)
unnamed: TP152.TP, U13.13 (!1Z)
unnamed: TP144.TP, U13.10 (2Y)
unnamed: TP148.TP, U13.11 (!2Z)
unnamed: TP155.TP, U14.14 (1Y)
unnamed: TP151.TP, U14.13 (!1Z)
unnamed: TP143.TP, U14.10 (2Y)
unnamed: TP147.TP, U14.11 (!2Z)
unnamed: TP132.TP, U25.14 (1Y)
unnamed: TP129.TP, U25.13 (!1Z)
unnamed: TP123.TP, U25.10 (2Y)
unnamed: TP126.TP, U25.11 (!2Z)
unnamed: TP165.TP, U4.10 (2Y)
unnamed: TP168.TP, U4.11 (!2Z)
unnamed: R117.1, U14.12 (DE)
unnamed: TP170.TP, U4.13 (!1Z)
unnamed: TP153.TP, U20.14 (1Y)
unnamed: TP149.TP, U20.13 (!1Z)
unnamed: TP141.TP, U20.10 (2Y)
unnamed: TP145.TP, U20.11 (!2Z)
unnamed: R118.1, U13.12 (DE)
unnamed: R116.1, U20.12 (DE)
unnamed: R115.1, U17.12 (DE)
unnamed: R114.1, U30.12 (DE)
unnamed: TP116.TP, U30.9 (2D)
unnamed: TP134.TP, U30.15 (1D)
unnamed: TP128.TP, U30.13 (!1Z)
unnamed: TP131.TP, U30.14 (1Y)
unnamed: TP121.TP, U30.10 (2Y)
unnamed: TP124.TP, U30.11 (!2Z)
unnamed: R107.9, TP105.TP
unnamed: R104.9, TP102.TP
unnamed: R106.9, TP104.TP
unnamed: R103.9, TP101.TP
unnamed: R105.9, TP103.TP
unnamed: Q2.3 (S), Q2.4 (G), TP113.TP, TP119.TP
unnamed: Q2.5 (D), Q2.6 (D), TP115.TP
unnamed: TP174.TP, U7.2 (1A)
unnamed: R102.9, TP100.TP
unnamed: TP177.TP, U7.1 (!1B)
unnamed: TP171.TP, U7.3 (1R)
unnamed: TP178.TP, U3.1 (!1B)
unnamed: TP175.TP, U3.2 (1A)
unnamed: TP172.TP, U3.3 (1R)
unnamed: TP164.TP, U7.6 (2A)
unnamed: TP161.TP, U7.7 (!2B)
unnamed: TP167.TP, U7.5 (2R)
unnamed: TP166.TP, U3.6 (2A)
unnamed: TP163.TP, U3.7 (!2B)
unnamed: TP169.TP, U3.5 (2R)
unnamed: R123.2, U7.4 (!RE)
unnamed: R122.2, U3.4 (!RE)
unnamed: TP133.TP, U24.2 (1A)
unnamed: TP136.TP, U24.1 (!1B)
unnamed: TP120.TP, U24.6 (2A)
unnamed: TP114.TP, U24.7 (!2B)
unnamed: TP130.TP, U24.3 (1R)
unnamed: TP127.TP, U24.5 (2R)
unnamed: R109.2, U24.4 (!RE)
unnamed: P1.41, TP190.TP
unnamed: P1.43, TP189.TP
unnamed: P1.45, TP188.TP
unnamed: P1.47, TP187.TP
unnamed: P3.41, TP182.TP
unnamed: P3.39, TP183.TP
unnamed: P3.37, TP184.TP
unnamed: P3.35, TP185.TP
unnamed: P3.33, TP186.TP
unnamed: P3.47, TP179.TP
unnamed: P3.45, TP180.TP
unnamed: P3.43, TP181.TP
unnamed: LED1.A, R1.1
TP59: P10.39, TP108.TP
TP60: P11.39, TP107.TP
TP61: P12.39, TP106.TP
T_ATTN_N: P10.30, R105.2
T_ATTN_P: P10.29, R105.1
T_C00_N: P10.13, R107.7
T_C00_P: P10.14, R107.8
T_C01_N: P10.16, R106.2
T_C01_P: P10.15, R106.1
T_C02_N: P10.17, R106.15
T_C02_P: P10.18, R106.14
T_C03_N: P10.20, R106.4
T_C03_P: P10.19, R106.3
T_C04_N: P10.21, R106.13
T_C04_P: P10.22, R106.12
T_C05_N: P10.24, R106.6
T_C05_P: P10.23, R106.5
T_C06_N: P11.13, R104.5
T_C06_P: P11.14, R104.6
T_C07_N: P11.16, R104.11
T_C07_P: P11.15, R104.10
T_C08_N: P11.17, R104.7
T_C08_P: P11.18, R104.8
T_C09_N: P11.20, R103.2
T_C09_P: P11.19, R103.1
T_C10_N: P11.21, R103.15
T_C10_P: P11.22, R103.14
T_C11_N: P11.24, R103.4
T_C11_P: P11.23, R103.3
T_C12_N: P12.16, R101.13
T_C12_P: P12.15, R101.12
T_C13_N: P12.17, R101.6
T_C13_P: P12.18, R101.5
T_C14_N: P12.20, R101.11
T_C14_P: P12.19, R101.10
T_C15_N: P12.21, R101.8
T_C15_P: P12.22, R101.7
T_CPA_N: P12.24, R101.9
T_CPA_P: P12.23, R100.1
T_CTOD_N: P10.34, R105.4
T_CTOD_P: P10.33, R105.3
T_D00_N: P10.1, R107.1
T_D00_P: P10.2, R107.2
T_D01_N: P10.4, R107.15
T_D01_P: P10.3, R107.14
T_D02_N: P10.5, R107.3
T_D02_P: P10.6, R107.4
T_D03_N: P10.8, R107.13
T_D03_P: P10.7, R107.12
T_D04_N: P10.9, R107.5
T_D04_P: P10.10, R107.6
T_D05_N: P10.12, R107.11
T_D05_P: P10.11, R107.10
T_D06_N: P11.1, R105.10
T_D06_P: P11.2, R105.11
T_D07_N: P11.4, R105.7
T_D07_P: P11.3, R105.8
T_D08_N: P11.5, R104.1
T_D08_P: P11.6, R104.2
T_D09_N: P11.8, R104.15
T_D09_P: P11.7, R104.14
T_D10_N: P11.9, R104.3
T_D10_P: P11.10, R104.4
T_D11_N: P11.11, R104.13
T_D11_P: P11.12, R104.12
T_D12_N: P12.1, R102.6
T_D12_P: P12.2, R102.5
T_D13_N: P12.4, R102.13
T_D13_P: P12.3, R102.12
T_D14_N: P12.5, R102.8
T_D14_P: P12.6, R102.7
T_D15_N: P12.8, R102.11
T_D15_P: P12.7, R102.10
T_D16_N: P12.9, R101.2
T_D16_P: P12.10, R101.1
T_D17_N: P12.12, R101.15
T_D17_P: P12.11, R101.14
T_DEM_N: P12.35, R100.6
T_DEM_P: P12.36, R100.7
T_DPA_N: P12.13, R101.4
T_DPA_P: P12.14, R101.3
T_DS00_N: P12.28, R100.14
T_DS00_P: P12.27, R100.15
T_DS01_N: P12.31, R100.13
T_DS01_P: P12.32, R100.12
T_DS02_N: P12.33, R100.11
T_DS02_P: P12.34, R100.10
T_EBL_N: P11.29, R103.11
T_EBL_P: P11.30, R103.10
T_EXC_N: P11.25, R103.13
T_EXC_P: P11.26, R103.12
T_INIT_N: P11.36, R102.14
T_INIT_P: P11.35, R102.15
T_OCC_N: P12.25, R100.2
T_OCC_P: P12.26, R100.3
T_RS00_N: P11.28, R103.6
T_RS00_P: P11.27, R103.5
T_RS01_N: P11.31, R103.7
T_RS01_P: P11.32, R103.8
T_RS02_N: P11.33, R102.1
T_RS02_P: P11.34, R102.2
T_RS03_N: P10.28, R106.7
T_RS03_P: P10.27, R106.8
T_RS04_N: P10.31, R105.15
T_RS04_P: P10.32, R105.14
T_RUN_N: P10.37, R105.5
T_RUN_P: P10.38, R105.6
T_SCLK_N: P10.25, R106.11
T_SCLK_P: P10.26, R106.10
T_SP1_N: P11.37, R102.3
T_SP1_P: P11.38, R102.4
T_SP2_N: P12.37, R100.8
T_SP2_P: P12.38, R100.9
T_TRA_N: P12.30, R100.5
T_TRA_P: P12.29, R100.4
T_WCLK_N: P10.35, R105.13
T_WCLK_P: P10.36, R105.12

Notes on the sheet:
MISCELLANEOUS
SPARES
MASSBUS TERMINATION
BYPASSING
000-0005

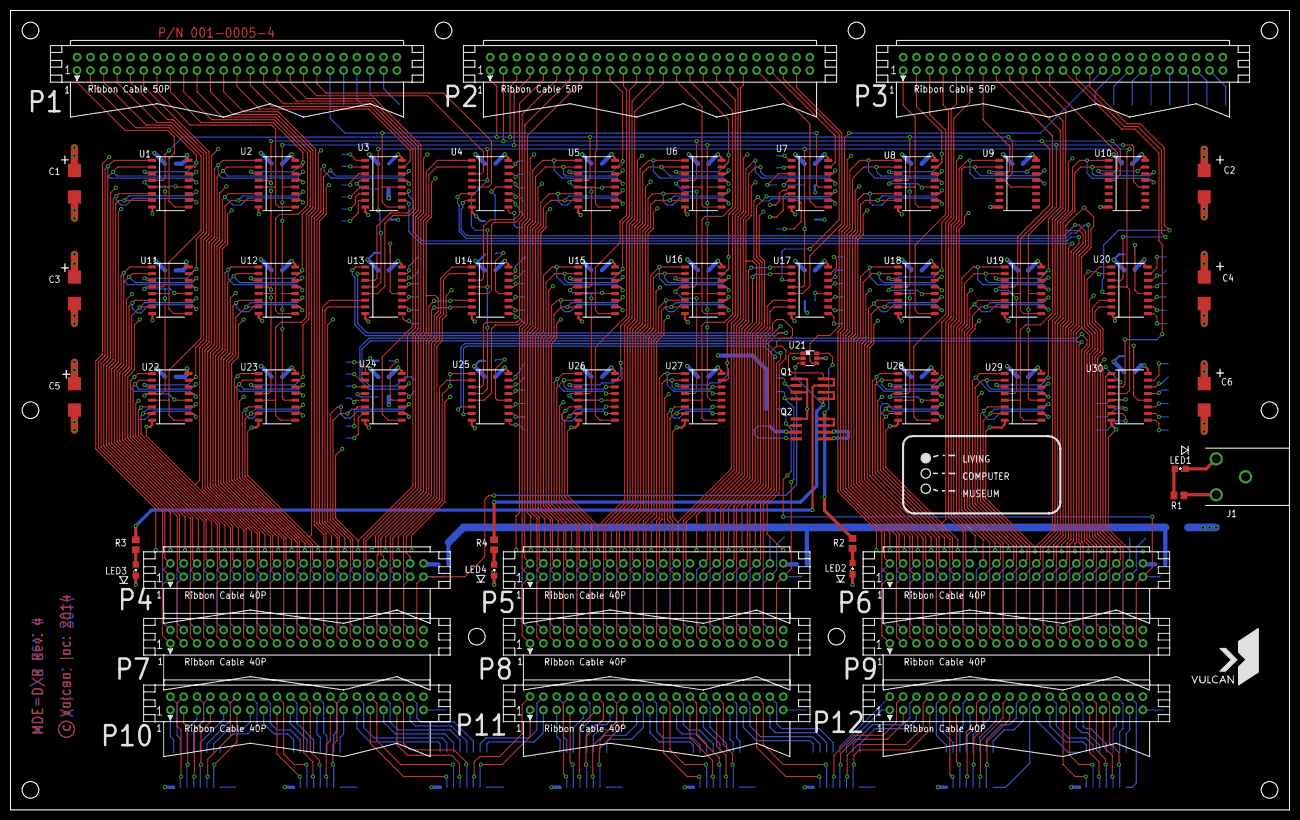
[picture p10: board MDE-DR-4.brd from above]

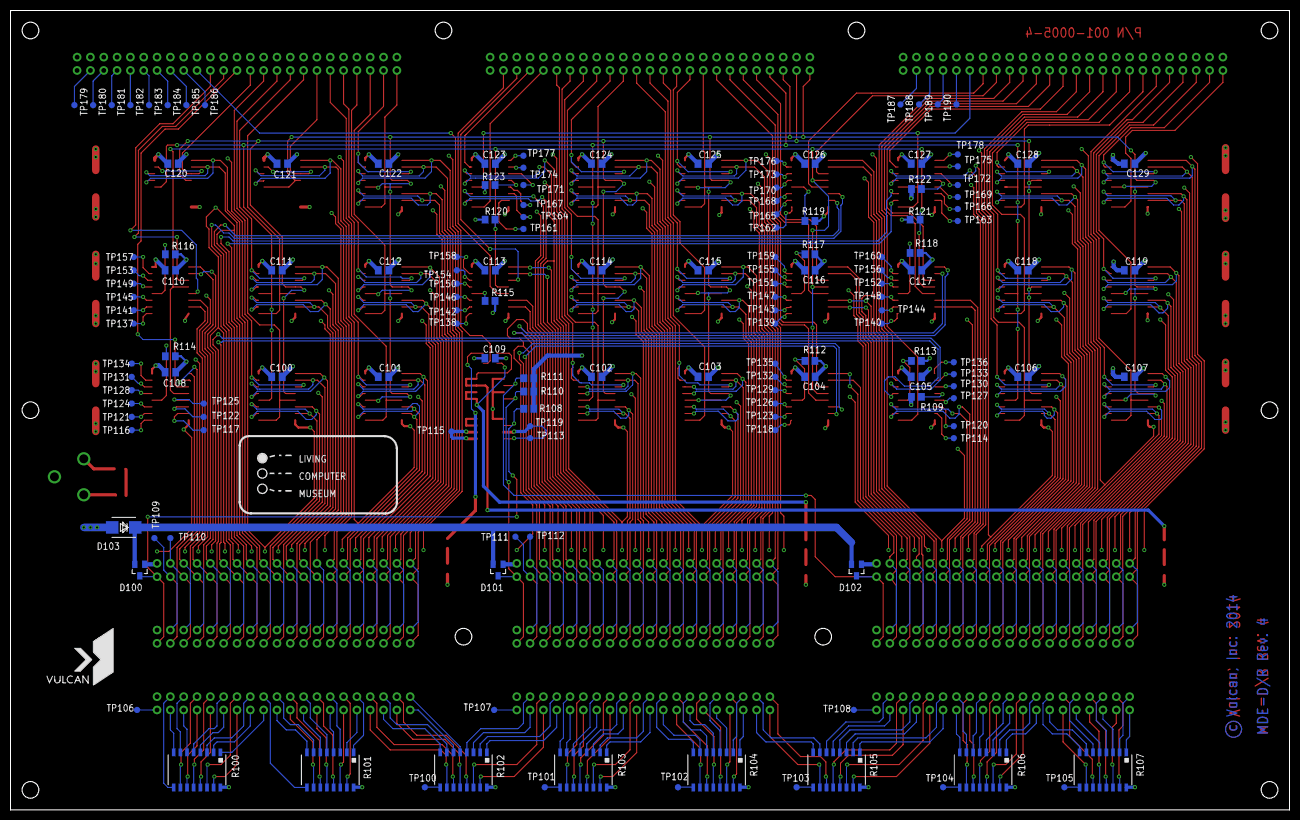
[picture p11: board MDE-DR-4.brd from below]

Board: 4 copper layers, 243.8 x 152.4 mm, 209 parts (149 on the bottom side), 398 nets.

Other parts of the board:
DRILEGEND: DRILEGEND
